jacobolofsson/Othello-bot/Documentation/project_report/project_report.tex

\documentclass[a4paper]{article}
\usepackage[swedish]{babel}
\usepackage[margin=2.5cm]{geometry}
\usepackage[T1]{fontenc}
\usepackage[utf8]{inputenc}

\pagenumbering{roman}

\usepackage{tabularx}

\usepackage[dvipsnames]{xcolor}
\usepackage{listings}
\lstset{
	language=c++,
	basicstyle=\ttfamily,
	keywordstyle=\bfseries\color{red},
	commentstyle=\itshape\color{ForestGreen},
	identifierstyle=\color{blue},
    stringstyle=\color{orange},
	numbers=left,
	frame=single,
	captionpos =b,
	breaklines=true
	escapeinside=`',
	escapebegin={\color{editorGray}}
	}
		
\usepackage{graphicx}
\graphicspath{ {../Drawings/} }

\begin{document}
\title{
	\textbf{Othellobot}\\
	\textit{Elektromekaniskt projekt (5hp)}
}
\author{Jacob Olofsson, Thomas Danielsson, Aksel Wännström}
\maketitle

\pagebreak

\begin{abstract}
Denna rapport beskriver ett konstruktionsprojekt med mål att konstruera en robot som kan spela brädspelet Othello (även kallat reversi) mot en mänsklig spelare.
Pjäserna konstruerades i plast med en permanentmagnet inuti.
Hall-sensorer monterades sedan i spelplanen för att kunna läsa av ifall rutorna i spelplanen var tomma, innehöll svarta pjäser eller vita pjäser.
Ett AI baserat på en Monte Carlo-algoritm beräknar sedan det bästa möjliga draget.
Detta drag utförs sedan med en robotarm som flyttar sig längs en bana ovanför spelplanen som håller den magnetiska spelpjäsen med hjälp av en elektromagnet.
\end{abstract}

\tableofcontents

\pagebreak
\pagenumbering{arabic}

\section{Introduktion}
\subsection{Othello}
Spelet \textit{Reversi} uppfanns på 1880-talet i london och har sedan dess spritt sig runt hela världen.
Idag är spelet mer känt vid namnet \textit{Othello}.

\subsubsection*{Spelregler}
Spelet spelas av två spelare, hädanefter svart och vit.
Spelplanen är normalt ett bräde indelat i 8x8 rutor men kan spelas med ett mindre eller större antal rutor.
Spelpjäserna är svarta på ena sidan och vita på den andra.
Sidan som ligger uppåt visar vilken spelare pjäsen hör till.
Spelet startar med fyra pjäser, två från varje spelare i mitten i ett schackmönster.
Spelarna turas om att placera ut en pjäs i taget i ett tomt fält.
När en pjäs placeras ut ska alla av motspelarens pjäser som ligger i raka linjer (horisontella, vertikala eller diagonala) mellan den utplacerade pjäsen och en annan pjäs av den spelande spelaren vändas.
Ett drag är endast tillåtet om minst en av motståndarens pjäser vänds av draget.
Ifall det inte finns några möjliga drag måste spelaren passa sin tur tills det finns ett möjligt drag att göra.
När ingen kan göra några fler drag är spelet slut och den spelare med mest pjäser på brädet vinner.

\subsection{Mål}
Målet med detta projekt är att att konstruera en robot och ett AI som kan spela Othello mot en mänsklig motståndare.
AI:t ska kunna hämta tillräckligt med information för att göra ett drag som är tillåtet enligt spelets regler.

\section{Teori}
För att en robot ska kunna spela Othello måste den på något sätt kunna läsa av spelplanen, tänka fram ett bra drag och sedan fysiskt utföra draget.

\subsection{AI-algoritm} \label{AI}
Ett vanligt sätt att bygga ett AI för att spela ett spel är att på något sätt bygga ett beslutsträd där alla möjliga drag utvärderas.
Denna sorts algoritm växer exponentiellt i både tids- och minneskomplexitet vilket gör att den inte lämpar sig särskilt bra för en resursbegränsad plattform som t.ex. en mikrokontroller.
Därför har vi valt att använda oss av en Monte Carlo-metod.
Monte Carlo-metoden går ut på att istället för att bygga ett stort träd simuleras spel utifrån den nuvarande uppställningen på planen med slumpmässiga drag.
Programmet håller räkningen på vinster och förluster och väljer sedan det drag som i genomsnitt lett till flest vinster bland de slumpade spelen.
Denna algoritm använder en konstant minneskomplexitet och kommer att ge ett bättre svar desto längre den får tänka men betänketiden går att anpassa exakt efter omständigheterna.
Algoritmen kan sammanfattas i följande steg:
\begin{itemize}
\item Hämta alla möjliga drag
\item Medan tidsbegränsningen inte gått ut: 
	\begin{itemize} 
	\item Välj nästa möjliga drag
	\item Utför draget och starta simulering
	\item Medan simuleringen (spelet) inte är över:
		\begin{itemize}
		\item Byt spelare
		\item Gör slumpmässigt drag
		\end{itemize}	
	\item Spara vinst/förlust
	\end{itemize}
\item Välj det drag som gett mest vinster i medelvärde
\end{itemize}

\subsection{Sensorer}
För att kunna läsa av spelbrädet finns det många tillvägagångssätt.
Eftersom en robot som ska spela othello måste veta om varje ruta på spelplanen antingen är tom, har en svart spelpjäs eller en vit spelpjäs på sig finns det 3 olika tillstånd för varje ruta.
För detta ändamål lämpar sig någon form av linjär sensor som kan läsas av analogt bra.
Sensorer kan då sättas vid varje ruta på spelplanen och kalibreras så att de är mättade åt ena hållet för en svart pjäs,  mättade åt andra hållet för en vit pjäs och någonstans mitt emellan när rutan är tom.

\subsection{Robotarm}
För att roboten ska kunna plocka upp en pjäs och sedan släppa den på rätt plats på spelplanen behövs tre frihetsgrader.
Armen behöver kunna röra sig tvärsöver planen (två dimensioner) samt lyfta och sänka en pjäs den håller i.
Rörelserna kan dock vara ganska begränsade då roboten endast behöver komma åt ett antal fördefinierade rutor och inget utanför det (förutom att plocka upp en ny pjäs).
Rörelsen i höjdled kan vara ännu mer begränsad, den behöver egentligen vara binär.
Antingen är den i höjd för att plocka upp en spelpjäs eller så är den i höjd för att kunna flytta spelpjäsen ovanför de andra pjäserna.

\section{Metod}
\subsection{Mjukvara}
Designen av mjukvaran är indelad i fem stycken moduler som ansvarar för sin egen del av designen och en toppnivå som knyter samman modulerna, se figur \ref{system_arch}.
Se appendix \ref{code} för fullständig kod.
\begin{figure}
\centering
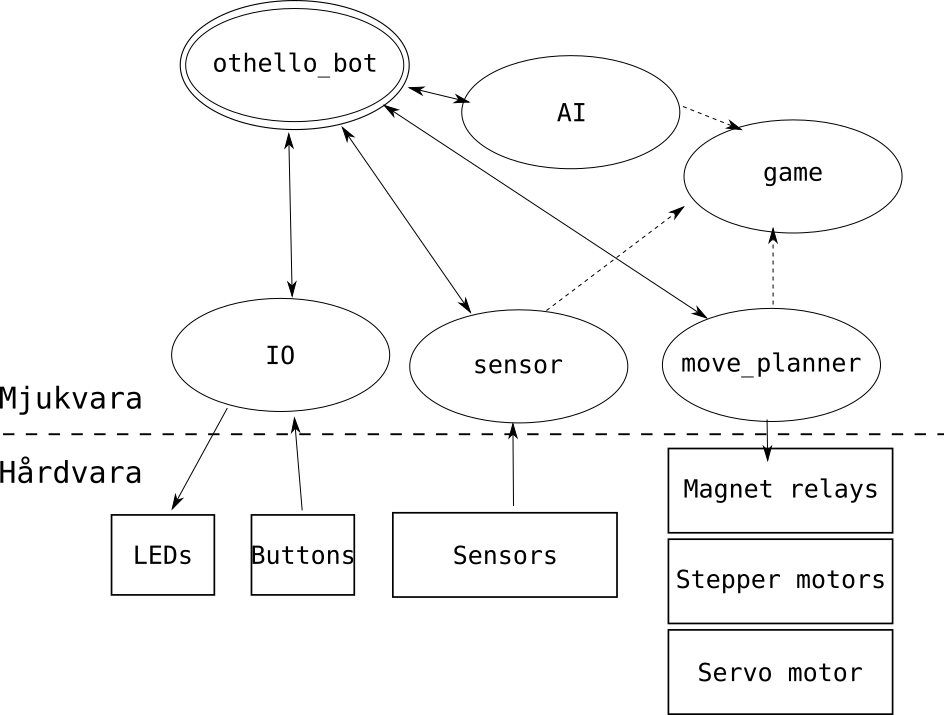
[picture p1: Documentation/Drawings/system_arch.png]

\caption{Den implementerade systemarkitekturen. Huvudmodulen \texttt{othello\_bot} kommunicerar med de andra undermodulerna. Det gemensamma interfacet \texttt{game} definierar objekten modulerna använder sig av.}
\label{system_arch}
\end{figure}

\subsubsection*{game}
Modulen \texttt{game} implementerar spelreglerna och definierar spelbrädet.
Modulen definierar även koordinaterna till spelbrädet och vad en spelare är.
Den här modulen har ingen kontakt med hårdvaran.

\subsubsection*{AI}
Modulen \texttt{AI} implementerar AI:t som beskrivts i del \ref{AI}.
Modulen tar ett state i form av ett spel och en spelarfärg som definieras i modulen \texttt{game} och beräknar det bästa draget.

\subsubsection*{move\_planner}
Modulen \texttt{move\_planner} ansvarar för att ta ett drag (i form av en spelare och en koordinat) och sedan utföra det fysiskt.
Det är den här modulen som har kontakt med hårdvaran för styrning.

\subsubsection*{IO}
Modulen \texttt{IO} ansvarar för att kommunicera med hårdvaran, att läsa av knappar för att programmet ska veta om de kan börja på nästa tur och skriva information om programmets status till LEDs.

\subsubsection*{sensor}
Modulen \texttt{sensor} ansvarar för att läsa av sensorerna i spelbrädet samt att tolka detta till en representation av spelbrädet som definierats i \texttt{game}.
Den här modulen har också direkt kontakt med hårdvaran.

\subsection{Hårdvara}
Som kontroller till projektet valdes en Arduino för att hålla komplexiteten i programmeringen nere.
Vidare valdes en Arduino Mega för att ha tillgång till så många analoga portar som möjligt för sensorerna samt att ha så mycket processorkraft som möjligt för AI:t.
Som linjära sensorer valdes Hall-sensorer och spelpjäserna konstruerades med magneter inuti.
Detta medförde att en elektromagnet blev ett passande val för att plocka upp och släppa pjäser.
Elektromagneten sattes på en två-dimensionell bana likt en 3D-skrivare och drivs med två stegmotorer (via kugghjul och kuggremmar) för precision.
Elektromagneten kan sedan sänkas eller höjas med ett servo.
Se ritningar i appendix \ref{sketches} för mer detaljer.

\section{Resultat}

\subsection{Mjukvara}
Efter kompilation tar programmet 6198b, 24\% av Arduino Megas dynamiska minne och all minnesallokering i programmet sker statiskt.
AI:t spelar spelet enligt reglerna och gör inga triviala fel.
Finns det ett drag som garanterar vinst väljer AI:t detta och finns det ett drag som garanterar förlust väljer AI:t det inte om andra val finns.
Desto mer processorkraft och betänketid, desto bättre spelar AI:t.
Tester gjorda på en \textit{2GHz Intel Core i7} uppmätte ca 40000 simuleringsiterationer per sekund (ca 50-klockcycler per iteration).

\subsection{Spelplan och sensorer}
Spelplanen konstruerades genom att sensorerna monterades på ett kretskort i ett rutnät, se figur \ref{board}.
Kretskortet fästes sedan på undersidan av en 3mm tunn plastskiva.
Sensorerna känner av spelpjäsernas magneter linjärt men magnetfältets täthet avtar snabbt med avståndet från sensorn.
Detta gör att spelpjäsen måste placeras väldigt precist.
Om spelpjäsen placeras med mer än 1cm avvikelse från tänkt position kommer sensorn inte klara av att känna av den.
\begin{figure}
\centering


\caption{Vänster: Undersidan av kretskort med sensorer. Höger: Ovansida monterad under spelplanen.}
\label{board}
\end{figure}

\subsection{Robotarm}
Förflyttningen skapades genom att bygga en ställning av metallstängerstänger.
Vinkellister tillverkades och användes som ställningar för att hålla ihop stängerna och även agera som plattform för att sätta fast elektromagnet, servo och stegmotor på den rörliga mittenplattan.
Systemet drivs av en stegmotor som är fäst på en av två metallstänger på varje sida av banan.
Stängerna är ihopkopplade med kughjul och remmar.
Detta kan ses i figur \ref{board_uppe}.
Ställningen kunde röra sig till viss del men på grund av friktion i ställningen orkade inte stegmotorerna att röra sig hela vägen till ändpunkterna.
Därigenom kunde endast 8stycken spelpjäser nås i nuvarande konfiguration.
\begin{figure}
\centering

\caption{Toppsidan av ställningen med spelplan under. Mitten ses elektromagentställningen med stegmotor för ena ledden. Andra ledden styrs av en stegmotor precis utanför bild ner till vänster.}
\label{board_uppe}
\end{figure}

\subsection{Elektromagnet}
Elektromagneten gjordes av en spik som lindades med koppartråd.
För att kunna lyfta en spelpjäs, hålla den och sedan släppa den genom att byta polaritet krävdes ca 2A vid 5V åt båda riktningarna.
Eftersom elektromagnetet måste kunna vända polaritet och leverera mycket ström kopplades båda ändarna av spolen till var sitt relä.
Reläna kan sedan styras som visas av konfigurationen i figur \ref{relay}.
\begin{figure}
\centering


\caption{Vänster: Servot för höjning och sänkning av elektromagneten. Höger: Spelplan med en pjäs upplockad av elektromagneten}
\label{servo_fram}
\end{figure}
\begin{figure}
\centering
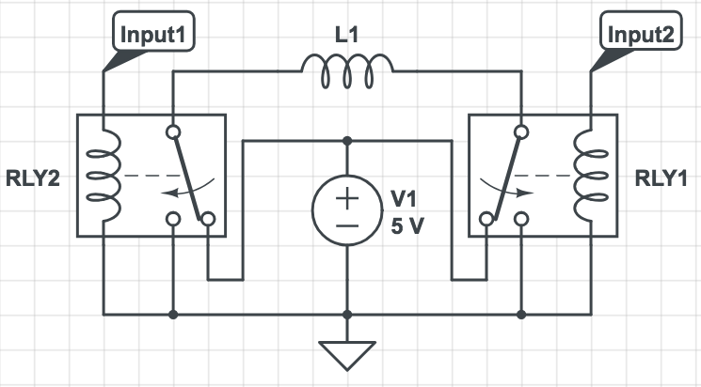
[picture p4: Documentation/Drawings/relay.png]

\caption{Kretsschema för styrningen av elektromagnetens spole. Med två reläer som styrs av var sin styrsignal kan riktningen på strömmen genom spolen styras}
\label{relay}
\end{figure}

\section{Diskussion och slutsats}
Utan att ha något formaliserat ramverk för att testa vad en bra othellospelare innebär är det inte möjligt att ge något absolut svar på hur bra AI:t fungerar.
Det som går att säga utifrån resultaten är att den spelar bättre än någon som bara lägger slumpmässigt. Då denna implementation inte är begränsad av minne ifall en Arduino Mega används som mikrokontroller skulle det gå att optimera programmet mer med avsseende på prestanda då Adruinos kompilator automatiskt optimerar för minnesanvändning ifall AI:t behöver göras bättre.
\\
\\
En stor modifikation som gjordes från originalritningen var att ett 4x4 spelbräde valdes istället för 8x8 för att hålla komplexiteten av konstruktionen nere.
Det finns inget som begränsar att konstruktionen skulle kunna utökas för ett större antal pjäser.
Det i designen som behöver modifieras är hur sensorerna avläses.
Ifall mikrokontrollern som används inte har tillräckligt många portar behövs en analog multiplexer användas  för att läsa av all sensorer.
\\
\\
Den färdigkonstruerade armen hade tillräckligt med rörlighet för att nå alla pjäser men på grund ojämnheter och mätfel vid tillverkning av banorna blev det mycket hög friktion mellan de rörliga delarna när de kom långt bort från mittläget.
Detta gör att stegmotorerna har för llitet vridmoment för att kunna övervinna friktionen och endast ca hälften av positionerna på brädet kan nås.
Detta hade kunnat motverkas med större nogrannhet vid tillverkningen av banorna för armen.
En större nogrannhet vid tillverkningen hade även kunnat möjligjort för högre precision vid robotens placering av pjäser.
Andra alternativa sätt att överkomma friktionen är att använda material med mindre friktion för att tillverka glidlagren och att använda stegmotorer med högre vridmoment.
\\
\\
Sensorerna i spelplanen fungerar bra men är väldigt känsliga för att pjäserna placeras med hög precision.
Spelplanen var den del som fungerade bäst, denna kunde känna av spelpjäserna och vilken av sidorna som var uppåt.
\\
\\
Vid vidare utveckling är dessa några funktioner man skulle kunna lägga till efter grundfunktionerna fungerar: 
\begin{itemize}
    \item Möjlighet att välja färg på AI:t
    \item Efter AI:t utfört ett drag vänder den alla pjäser som blir påverkade av draget
    \item Mekanismen plockar upp nya pjäser att lägga ut på planen utan mänsklig hjälp
    \item AI:n gör smartare drag
    \item Möjlighet att ställa in betänketid och/eller svårighetsgrad utan tillgång till källkoden
    \item Display som kan visa mer information om programmets status
    \item AI:t känner av när motståndaren utfört sitt drag och fortsätter automatiskt med sitt drag utan input
\end{itemize}

\pagebreak
\begin{appendix}
\section{Källkod} \label{code}
\subsection{othello\_bot.ino}
\lstinputlisting{../../othello_bot/othello_bot.ino}
\subsection{game.hpp}
\lstinputlisting{../../othello_bot/game.hpp}
\subsection{game.cpp}
\lstinputlisting{../../othello_bot/game.cpp}
\subsection{AI.hpp}
\lstinputlisting{../../othello_bot/AI.hpp}
\subsection{AI.cpp}
\lstinputlisting{../../othello_bot/AI.cpp}
\subsection{sensor.hpp}
\lstinputlisting{../../othello_bot/sensor.hpp}
\subsection{sensor.cpp}
\lstinputlisting{../../othello_bot/sensor.cpp}
\subsection{move\_planner.hpp}
\lstinputlisting{../../othello_bot/move_planner.hpp}
\subsection{move\_planner.cpp}
\lstinputlisting{../../othello_bot/move_planner.cpp}
\subsection{IO.hpp}
\lstinputlisting{../../othello_bot/IO.hpp}
\subsection{IO.cpp}
\lstinputlisting{../../othello_bot/IO.cpp}
\subsection{config.hpp}
\lstinputlisting{../../othello_bot/config.hpp}
\subsection{random.hpp}
\lstinputlisting{../../othello_bot/random.hpp}

\section{Ritningar}\label{sketches}
\subsection{Spelbräde}
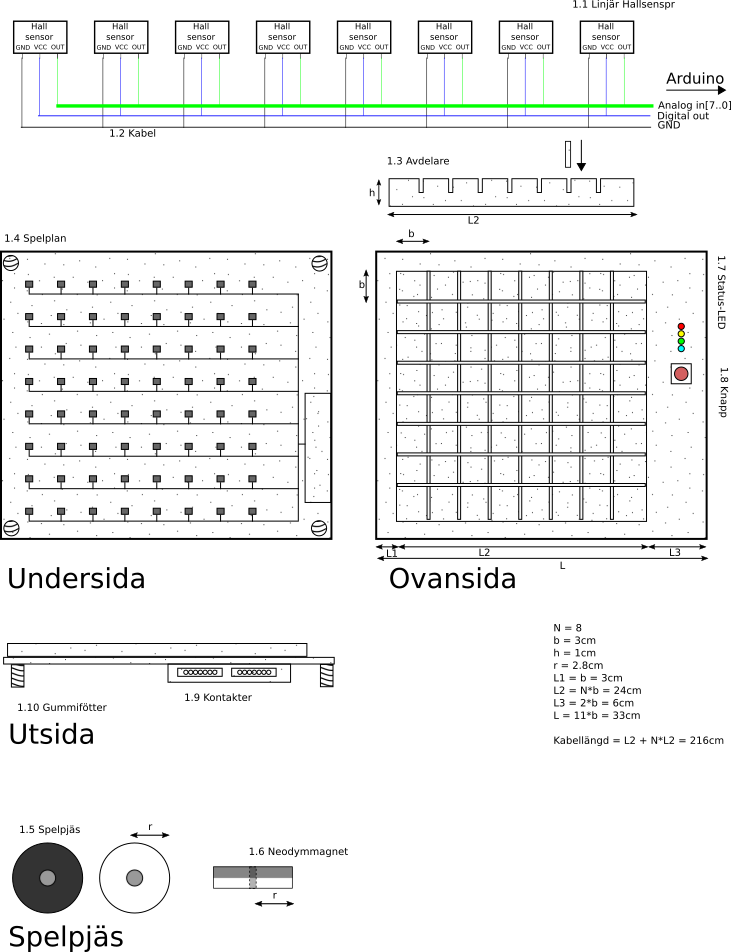
[picture p5: Documentation/Drawings/board.png]


\subsection{Robotarm}\label{arm}
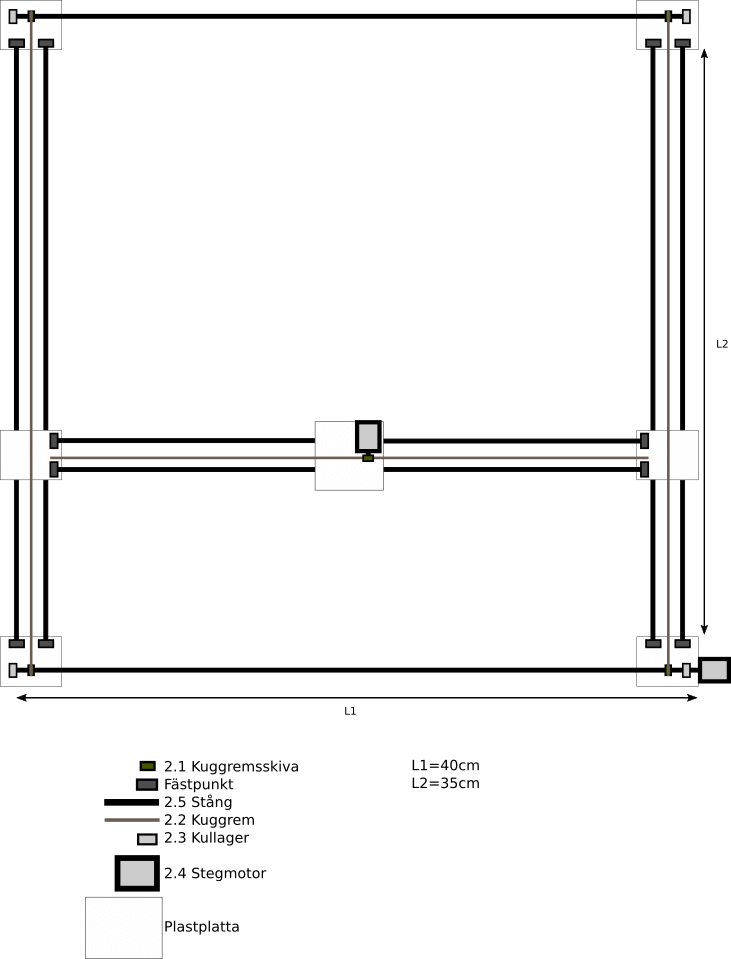
[picture p6: Documentation/Drawings/arm.png]


\section{Materiallista}
    \centering
        \begin{tabular}{ | l | l | r | }
\hline
Del & Benämning & Antal/storlek \\
\hline
\hline
0.1 & Arduino Mega & 1st \\
1.1 & Linjär Halleffektsensor & 64st \\
1.2 & Kopplingskabel & 16x220cm \\
1.3 & Avdelare, plastglas & 14x24cm \\
1.4 & Plan, plastglas & 33x33cm \\
1.5 & Spelpjäs, trä & 1x45x45cm \\
1.6 & Neodymmagnet 5mmx5mm & 64st \\
1.7 & LED, 3mm grön & 4st \\
1.8 & Vippa & 1st \\
1.9 & Flatkabel, 26 poler & 0,5m \\
1.9 & Stiftlister & 2st \\
1.10 & Gummifötter & 4st \\
2.1 & Kuggremsskiva 6mm & 4st \\
2.2 & Kuggrem & 3m \\
2.3 & Kullager & 4st \\
2.4 & Stegmotor & 2st \\
2.5 & Axel 6mm & 6st \\
2.6 & Glidlager 6mm & 6st \\
2.7 & Ställning för stegmotor & 2st \\
2.8 & Stegmotordrivare & 1st \\
2.9 & Batterieliminator & 1st \\
2.10 & LCD & 1st \\
2.11 & Kuggremsskiva 5mm & 1st \\
2.12 & Plattor som fästpunkt & 4st \\
2.13 & Lim/epoxy för bland annat plast & 1st \\
3.1 & Servo & 1st \\
3.2 & Metalstav 10mm x 20cm & 1st \\
3.3 & Elektromagnet (ur relä) & 1st \\
3.4.1 & Skruv 5mm & 6st \\
3.4.2 & Mutter 5mm & 6st \\
\hline
        \end{tabular}

\end{appendix}

\end{document}
