jacobolofsson/Othello-bot/Documentation/images/board_side.jpg

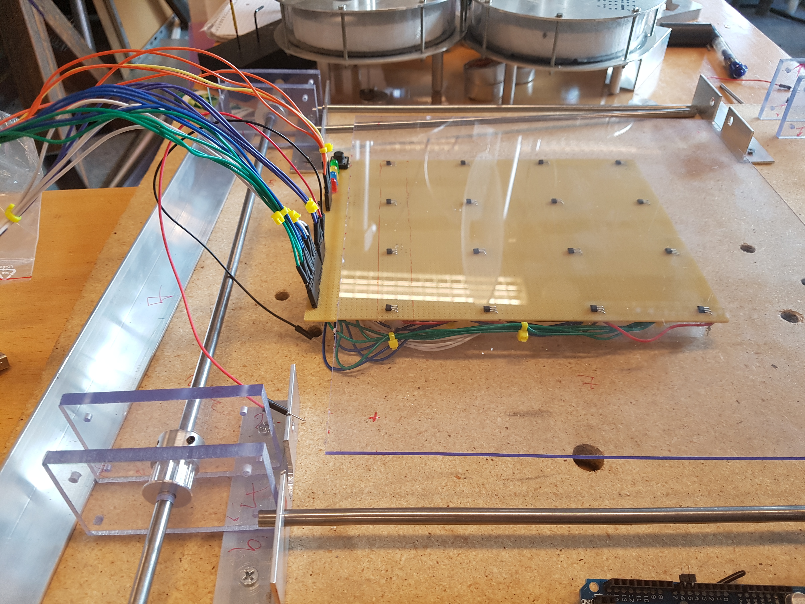
Documentation/images/board_side.jpg
