jacobolofsson/Othello-bot/Documentation/images/servo_front.jpg

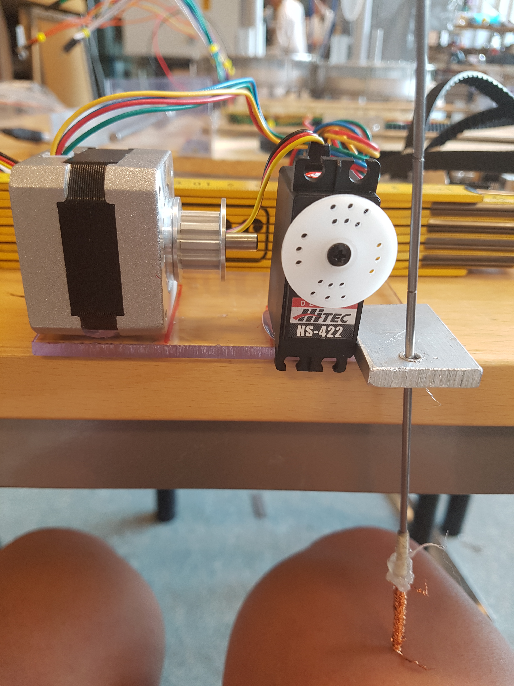
Documentation/images/servo_front.jpg
