jacobolofsson/Othello-bot/Documentation/materials_SE.md

# Delar
| Del | Benämning | Antal | Butik 1 | Butik 2 | Artikelnumer | Pris/sek ink moms |
| --- | --- | ----- | --- | --- | --- | ---- |
| 0.1 | Arduino Mega | 1st | [Elfa](https://www.elfa.se/sv/mikrostyrenhetskort-mega2560-r3-a000067-atmega2560-arduino-a000067/p/11038920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) | [Conrad](https://www.conrad.se/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) | A000067 | 437,50 |
| 1.1 | Linjär Halleffektsensor (billig men finns endast hos 1 svensk leverantör) | 64st | [Conrad](https://www.conrad.se/category.htm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) | []() | AH3503UA | 7,64 |
| 1.1 | Linjär Halleffektsensor (dyr) | 64st | [Electrokit](https://www.electrokit.com/allegro-a1301-sip3-halleffektsensor-2-5mv-g.52933) | [Elfa](https://www.elfa.se/en/hall-effect-switch-sip-allegro-a1203eua/p/17333881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) | Allegro A1302 SIP-3 | 16,25 | 
| 1.2 | Kopplingskabel | 16x220cm | [Electrokit](https://www.electrokit.com/kopplingstrad-0-05mm%25C2%25B2-50m-svart.54262)  | [Elfa](https://www.elfa.se/sv/kopplingstrad-50-mm-svart-tinned-copper-silikon-rnd-cable-rnd-475-00485/p/30090251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) | 41015043 | 179 |
| 1.3 | Avdelare, plastglas | 14x24cm | [Biltema](http://www.biltema.se/sv/Bygg/Ovrigt/Plastglas-2000030030/) | [Jula](https://www.jula.se/catalog/bygg-och-farg/beslag/inredningsbeslag/plastskivor/akrylplast-341071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) | 26207 | 39 |
| 1.4 | Plan, plastglas | 33x33cm | [Biltema](http://www.biltema.se/sv/Bygg/Ovrigt/Plastglas-2000030030/)| [Jula](https://www.jula.se/catalog/bygg-och-farg/beslag/inredningsbeslag/plastskivor/akrylplast-341071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) | 26207 | 39 |
| 1.5 | Spelpjäs, trä | 1x45x45cm | [Bauhaus](https://www.bauhaus.se/mdf-skiva-10mm-10x1220x2440mm.html) | [Byggmax](https://www.byggmax.se/skivmaterial/byggskivor/mdf/mdf-p10082) | MDF-skiva | 189 | 
| 1.6 | Neodymmagnet 5mmx5mm | 64st | [Electrokit](https://www.electrokit.com/magnet-neo35-o5mm-x-5mm.50573) | [Elfa](https://www.elfa.se/en/bar-magnet-neo-35-sura-magnets-na35-005/p/13752011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) | 41011480 | 7,13 |
| 1.7 | LED, 3mm grön | 4st | [Elfa](https://www.elfa.se/sv/lysdiod-mm-t1-groen-kingbright-7104gd/p/17510161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) | [Electrokit](https://www.electrokit.com/led-gron-3mm-lagstrom-2ma-tllg4401.44653) | L-7104GD | 1,24 |
| 1.8 | Vippa | 1st | [Elfa](https://www.elfa.se/sv/vippstroemstaellare-on-off-1p-starcote-k3/p/13500600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) | [Electrokit](https://www.electrokit.com/vippomkopplare-1pol-lodoron-onon-mts102.42011?sort=price_asc) | 40220010 | 5,80 |
| 1.9 | Flatkabel, 26 poler | 0,5m | [Electrokit](https://www.electrokit.com/flatkabel-gra-26-ledare-1-27mm-m.44069) | [Elfa](https://www.elfa.se/sv/flatkabel-27-mm-25x0-08-mm-3m-3365-25/p/15566357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) | 31670224 | 31kr/m |
| 1.9 | Stiftlister | 2st | [Elfa](https://www.elfa.se/sv/stiftlist-hona-50-fischer-elektronik-mk01-50z/p/14384049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)  | [Electrokit](https://www.electrokit.com/stiftlist-2-54mm-1x40p-brytbar.43412) | 41001167 | 9 |
| 1.10 | Gummifötter | 4st | [Electrokit](https://www.electrokit.com/gummifot-o11x5mm-gra.43380?sort=price_asc) | [Elfa](https://www.elfa.se/sv/gummifoetteroo-25-mm-11-mm-svart-reinshagen-1841/p/14886891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) | 41001130 | 4 |
| 2.1 | Kuggremsskiva 6mm(Conrad och electrokit ej utbytbara på kuggrem och kuggremsskivor) | 4st | [Electrokit](https://www.electrokit.com/kuggremskiva-xl-10t-6mm.51634) | [Conrad](https://www.conrad.se/Aluminium-Tandad-remskiva-Reely-Borrdiameter:-6-mm-Diameter:-28-mm-Antal-t%E4nder:-15.htm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)|41012369/226017 |79/109|
| 2.2 | Kuggrem(Electrokit är att föredra, där går det att byta ut metervara till fasta längder om metervaran är slut) | 3m | [Electrokit](https://www.electrokit.com/kuggrem-xl-3-8-m.51829) |[Conrad](https://www.conrad.se/Kuggremmar-Reely-762-mm-Antal-t%E4nder-150.htm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) |41012621(finns även i fasta längder)/226098(3st) |39/m  /  69kr/st
| 2.3 | Kullager | 4st | [Conrad](https://www.conrad.se/Reely-Kullager-radiellt-Kromst%E5l-Inre-diameter:-6-mm-Ytterdiameter:-19-mm-Varvtal-%28max%2e%29:-40000-rpm.htm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) | [Svith](https://www.svith.se/traktorreservdelar-hydraulik/tillbehor-maskiner-och-traktorer/lager/kullager-sma/kullager-med-spar-6x19x6.html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)| 2050000076060/L626-2RSK|26/20
| 2.4 | Stegmotor | 2st | [Electrokit](https://www.electrokit.com/stegmotor-200-steg-varv-bipolar.45270) | [Kjell&Company](https://www.kjell.com/se/sortiment/el-verktyg/arduino/tillbehor/luxorparts-stegmotor-nema-17-p90776) | 41002881/90776| 199/179
| 2.5 | Axel 6mm(Helst Conrad då de är bättre längd) | 6st | [Conrad](https://www.conrad.se/category.htm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) | [Electrokit](https://www.electrokit.com/axel-rostfritt-stal-6mm-x-300mm.53001)|4016138152784/41013801 |45/49|
| 2.6 | Glidlager 6mm(Conrad är att föredra) | 6st | [Conrad](https://www.conrad.se/Glidlager-igus-JSM-0608-06-Borrdiameter-6-mm.htm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)| [Electrokit](https://www.electrokit.com/lagerbock-o6mm-plast.51303) |2050003794602/41012042 |26/59|
| 2.7 | Ställning för stegmotor | 2st | [Kjell&Company](https://www.kjell.com/se/sortiment/el-verktyg/arduino/tillbehor/luxorparts-stegmotorhallare-nema-17-p90779) |  |90779| 39,9
| 2.8 | Stegmotordrivare(helst electrokit) | 1st | [Electrokit](https://www.electrokit.com/dubbel-stegmotordrivare-for-arduino.53090) | [Kjell&Company](https://www.kjell.com/se/sortiment/el-verktyg/arduino/moduler/stegmotordrivare-1-2-a-p88218) | 41013873/88218|199/119|
| 2.9 | Batterieliminator | 1st | [Kjell&Company](https://www.kjell.com/se/sortiment/el-verktyg/stromforsorjning/nataggregat/ac-dc/stallbar-utspanning/stallbar-natadapter-3-12-v-(dc)-3-6-w-p44108) | [Electrokit](https://www.electrokit.com/batterieliminator-12v-2a.50115) |44108/41011018|129,9/169|
| 2.10 | LCD | 1st | [Electrokit](https://www.electrokit.com/lcd-2x16-tecken-jhd162a-stn-bla-vit-led.44837) | [Kjell&Company](https://www.kjell.com/se/sortiment/el-verktyg/elektronik/optokomponenter/led-lcd-displayer/luxorparts-lcd-display-2x16-seriell-i2c-p90786) |41002513/90786|99/119,9|
| 2.11 | Kuggremsskiva 5mm | 1st | [Electrokit](https://www.electrokit.com/kuggremskiva-xl-10t-5mm.55066) | [Conrad](https://www.conrad.se/Aluminium-Tandad-remskiva-Reely-Borrdiameter:-6-mm-Diameter:-28-mm-Antal-t%E4nder:-15.htm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) |41015850/226017 |79/109|
| 2.12 | Skärbrädor(för plattor som fästpunkt) | 4st | [Ikea](http://www.ikea.com/se/sv/catalog/products/90202268/) |  |902.022.68 |15|
| 2.13 | Lim/epoxy för bland annat plast | 1st | [Clas Ohlson](https://www.clasohlson.com/se/Power-Epoxy-Loctite/34-8918) | [Biltema](http://www.biltema.se/sv/Bygg/Kemikalier/Epoxi/Epoxi-Superstark-2000028570/) |34-8918/362421 |89,9/74,9|
| 3.1 | Servo | 1st | [Elektrokit](https://www.electrokit.com/hs422-standard-servo-0-4nm.44887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)  | [Kjell&Company](https://www.kjell.com/se/sortiment/el-verktyg/elektronik/rc-tillbehor/tillbehor-servo-mottagare/luxorparts-s3003-standard-servo-4-1-kg-1-pack-p87902) | 41002565/87902 | 135/129:90 |
| 3.2 | Metalstav 10mm x 20cm | 1st | [Creative Company](https://www.cchobby.se/metallstang-dia-2-mm-l-10-cm-10st) |  [Monatno](http://www.montano.se/product.html/kalldragen-rundstang?category_id=24) | 58022 / Kompaxel S355J2G3C+C | 19/21 |
| 3.3 | Elektromagnet (ur relä) | 1st | [Elektrokit](https://www.electrokit.com/relaer.c148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) | [Kjell&Company](https://www.kjell.com/se/sortiment/hem-kontor-fritid/larm-sakerhet-overvakning/larm/detektorer-sensorer-brytare/universalrela-12-24-v-2-a-24-v-p50602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) | 41003940 / 50602  | 24/99 |
| 3.4.1 | Skruv 5mm | 6st | [Ahlsel](https://www.ahlsell.se/10/infastning/maskingangad-skruv/maskinskruv-rostfri/479517/) | [Elektrokit](https://www.electrokit.com/skruv-ph-m3x10.49898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) | 479517/41010773  | krävde inloggning/2.15 |
| 3.4.2 | Mutter 5mm | 6st | [Ahlsell](https://www.ahlsell.se/10/infastning/mutter/mutter-blankforzinkad/500291/) | [Elektrokit](https://www.electrokit.com/mutter-m3.49909) | 500291/41010787 | Krävde inloggning/ 0.70 |
