jacobolofsson/Othello-bot/othello_bot/othello_bot.ino

#include "config.hpp"
#include "game.hpp"
#include "sensor.hpp"
#include "AI.hpp"
#include "move_planner.hpp"
#include "IO.hpp"

const unsigned long AI_TIME_LIMIT_MS = CONF_AI_TIME_LIMIT_MS;
unsigned long startTime;

Player AIplayer = WHITE;
Coordinate AImove;
Board<4,4> board;
AI ai(Game(board), AIplayer);

Sensor sensor;
MovePlanner planner;
IO io(&board, &AImove);

enum state {IDLE, RESET_AI, THINK, MOVING, GAME_OVER, ERROR} state = IDLE;

void setup() {
    sensor.setup();
    planner.setup();
    io.setup();
    ai.setup();
}

void loop() {
    switch(state) {
        case RESET_AI:
            board = sensor.getBoard(); 
            ai = AI(Game(board), AIplayer);
            startTime = millis();
            if (ai.getNumMoves() > 0) {
                state = THINK;
            } else {
                state = GAME_OVER;
            break;
            };
        case THINK:
            if ( millis()-startTime < AI_TIME_LIMIT_MS ) {
                ai.think();
            } else {
                AImove = ai.getBestMove();
                planner.addMove(AImove, AIplayer);
                state = MOVING;
            };
            break;
        case MOVING:
            if (planner.isDone()) {
                state = IDLE;
            };
            break;
        case GAME_OVER: // Intentional fall through to default:
        case ERROR:     // Intentional fall through to default:
        case IDLE:      // Intentional fall through to default:
        default:
            if (io.isNewTurn()) {
                state = RESET_AI;
            };
        break;
    };
    sensor.read();
    planner.write();
    io.write(state);
}
