jacobolofsson/Othello-bot/othello_bot/AI.hpp

#ifndef AI_H
#define AI_H

#include "game.hpp"

// An AI that will provide the best move for a game of othello
// given enough time to think.
// It is important to check that there are avaliable moves before
// using getBestMove()
// Example:
//      AI ai = AI(game, player);
//      if (ai.getNumMoves > 0) {
//          for (int i = 0; i<1000; ++i) {
//              ai.think();
//          };
//          bestMove = getBestMove();
//      };
class AI {
    public:
        AI(Game g, Player p);

        static void setup(void);
        void think(void);
        int getNumMoves(void) const { return nAvaliableMoves; };
        Coordinate getBestMove(void) const;

    private:
        // Structure that holds data for the simulations the AI
        // uses to calculate the best move
        struct Simulation {
            Game game {Game(Board<4,4>())};
            Player turn;
            Coordinate startCoord;
            int nSimulations {0};
            int nWins {0};
            float getScore(void) const {
                return nSimulations == 0 ? 0 : nWins / (float) nSimulations;
            };
        };

        Game currentGame;
        Player AIplayer;
        static const int BUFFER_SIZE = 20;
        Simulation simulations[BUFFER_SIZE];
        int currentSim {0};
        int nAvaliableMoves {0};

        void step(Simulation s);
        void reset(Simulation s);
};

#endif // AI_H
