jacobolofsson/Othello-bot/(commit log)

2018-02-15 Added schematics
2018-02-19 Added part specification of board
2018-03-06 Splittade projektplan och materiallista
2018-03-06 Lagt till materiallistan
2018-04-04 Added tests and function stubs for game and board class
2018-04-05 Completed Board class and started on game. Added lots of tests
2018-04-16 Added data sheet for sensors used
2018-04-16 Added implementation comments for game and board class
2018-04-20 Implemented sensor funcitons
2018-05-11 Added data sheet for motor shield
2018-05-14 Added support for magnet
