jacobolofsson/Othello-bot/Documentation/images/servo_fram.jpg

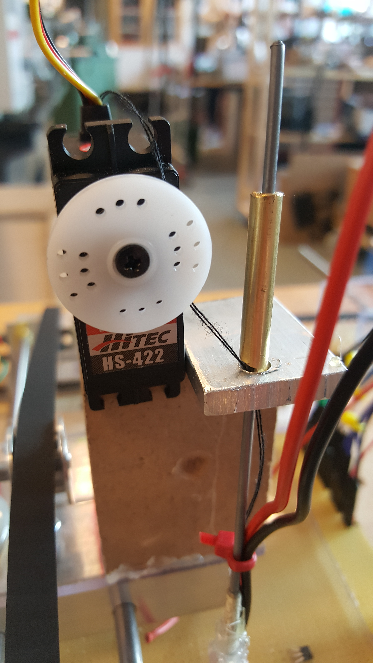
[picture p2: Documentation/images/servo_fram.jpg]
Documentation/images/servo_fram.jpg
