jacobolofsson/Othello-bot/Documentation/images/elektromagnet.jpg

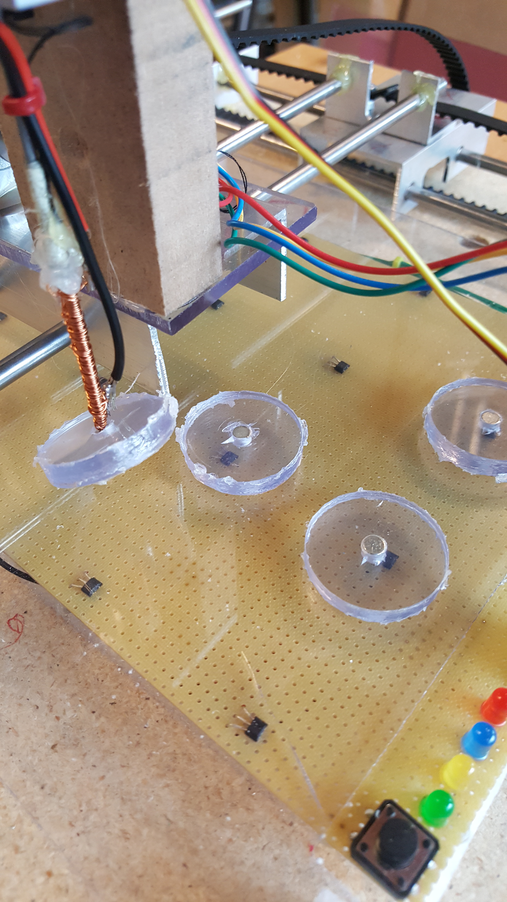
[picture p3: Documentation/images/elektromagnet.jpg]
Documentation/images/elektromagnet.jpg
