jacobolofsson/Othello-bot/Documentation/images/board_close.jpg

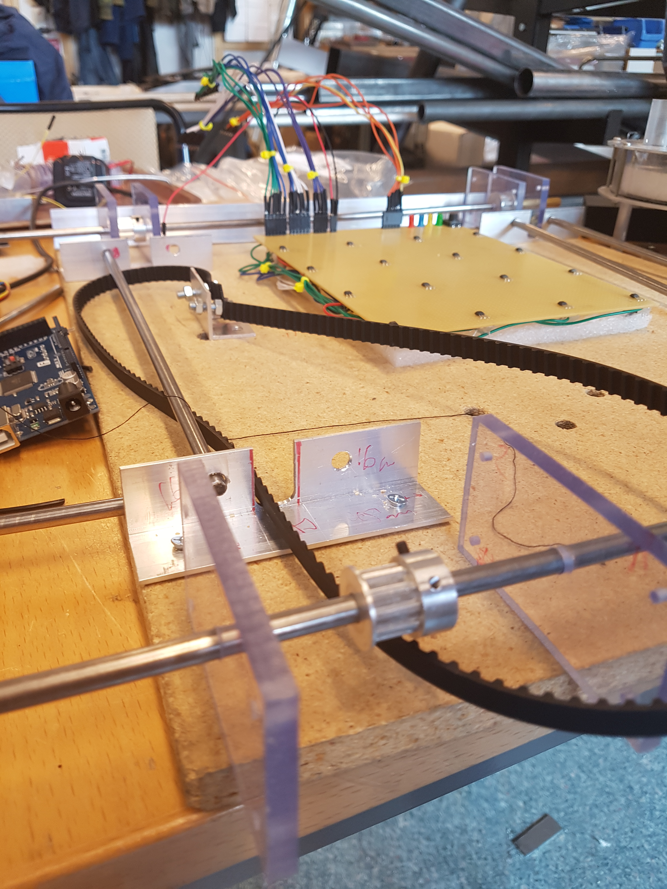
Documentation/images/board_close.jpg
